uva-linklab/powerblade/eagle/powerblade/BOM_powerblade_v6.1.xlsx

Index | Quantity | DigiKey Part Number | Manufacturer Part Number | Description | Customer Reference | Type | Package
1 | 5 | 535-12373-6-ND | ABS06-107-32.768KHZ-T | CRYSTAL 32.7680KHZ 4PF SMD | X2 | smt | 805
2 | 5 | 887-2003-6-ND | 8Y-16.000MAAV-T | CRYSTAL 16.0000MHZ 8PF SMD | X1 | smt | TXC-8Y
3 | 5 | 296-25252-6-ND | OPA369AIDCKR | IC OPAMP GP 12KHZ RRO SC70-5 | U5 | smt | SC70-5
4 | 5 | 296-27695-6-ND | TPS62122DRVR | IC REG BUCK ADJ 75MA SYNC 6SON | U1 | fine pitch | WDFN-6
5 | 5 | 296-19547-6-ND | OPA333AIDCKR | IC OPAMP CHOPPER 350KHZ SC70-5 | U2 | smt | SC70-5
6 | 5 | P953KLDKR-ND | ERJ-2RKF9533X | RES SMD 953K OHM 1% 1/10W 0402 | R23,R24 | smt | R0402
7 | 5 | P887KLDKR-ND | ERJ-2RKF8873X | RES SMD 887K OHM 1% 1/10W 0402 | R22 | smt | R0402
8 | 5 | P665KLDKR-ND | ERJ-2RKF6653X | RES SMD 665K OHM 1% 1/10W 0402 | R20 | smt | R0402
9 | 5 | P560KLDKR-ND | ERJ-2RKF5603X | RES SMD 560K OHM 1% 1/10W 0402 | R18 | smt | R0402
10 | 5 | P665KLDKR-ND | ERJ-2RKF6653X | RES SMD 665K OHM 1% 1/10W 0402 | R21 | smt | R0402
11 | 5 | P665KLDKR-ND | ERJ-2RKF6653X | RES SMD 665K OHM 1% 1/10W 0402 | R19 | smt | R0402
12 | 5 | P330KLDKR-ND | ERJ-2RKF3303X | RES SMD 330K OHM 1% 1/10W 0402 | R16 | smt | R0402
13 | 5 | P330KLDKR-ND | ERJ-2RKF3303X | RES SMD 330K OHM 1% 1/10W 0402 | R17 | smt | R0402
14 | 5 | P180KLDKR-ND | ERJ-2RKF1803X | RES SMD 180K OHM 1% 1/10W 0402 | R14 | smt | R0402
15 | 5 | P47KJDKR-ND | ERJ-2GEJ473X | RES SMD 47K OHM 5% 1/10W 0402 | R12 | smt | R0402
16 | 5 | P220KJDKR-ND | ERJ-2GEJ224X | RES SMD 220K OHM 5% 1/10W 0402 | R15 | smt | R0402_SM
17 | 5 | P20.0KLDKR-ND | ERJ-2RKF2002X | RES SMD 20K OHM 1% 1/10W 0402 | R10 | smt | R0402
18 | 5 | P69.8KAADKR-ND | ERJ-14NF6982U | RES SMD 69.8K OHM 1% 1/2W 1210 | R13 | smt | R1210
19 | 5 | P30.0KLDKR-ND | ERJ-2RKF3002X | RES SMD 30K OHM 1% 1/10W 0402 | R11 | smt | R0402
20 | 5 | P16.0KLDKR-ND | ERJ-2RKF1602X | RES SMD 16K OHM 1% 1/10W 0402 | R9 | smt | R0402
21 | 5 | P3.00KLDKR-ND | ERJ-2RKF3001X | RES SMD 3K OHM 1% 1/10W 0402 | R6 | smt | R0402_SM
22 | 5 | P4.99KLDKR-ND | ERJ-2RKF4991X | RES SMD 4.99K OHM 1% 1/10W 0402 | R7 | smt | R0402
23 | 5 | P200LDKR-ND | ERJ-2RKF2000X | RES SMD 200 OHM 1% 1/10W 0402 | R4 | smt | R0402
24 | 5 | P1.00KLDKR-ND | ERJ-2RKF1001X | RES SMD 1K OHM 1% 1/10W 0402 | R5 | smt | R0402
25 | 5 | ED1649-ND | 0965-0-15-20-80-14-11-0 | CONTACT SPRING LOADED SMD GOLD | J1 | smt | Ultra Low Profile Spring Pin
26 | 5 | 587-1521-6-ND | HK100515NJ-T | FIXED IND 15NH 320MA 460 MOHM | L2 | smt | 0402_CAP
27 | 5 | P75.0LDKR-ND | ERJ-2RKF75R0X | RES SMD 75 OHM 1% 1/10W 0402 | R3 | smt | R0402
28 | 5 | 490-4025-6-ND | LQM18FN100M00D | FIXED IND 10UH 50MA 900 MOHM SMD | L4 | smt | C0603_TN
29 | 5 | 478-8650-6-ND | F981A336MSA | CAP TANT 33UF 20% 10V 0805 | C27 | smt | CPOL0805_SM
30 | 5 | 732-3452-6-ND | 744760410A | FIXED IND 10UH 80MA 5 OHM SMD | L3 | smt | L0805
31 | 5 | 490-4990-6-ND | LQH2MCN100M52L | FIXED IND 10UH 200MA 2.27 OHM | L1 | smt | L0805
32 | 5 | 445-13815-6-ND | C1005X5R0J155K050BB | CAP CER 1.5UF 6.3V X5R 0402 | C21 | smt | C0402
33 | 5 | 497-13637-6-ND | BAL-NRF01D3 | BALUN 2.4GHZ-2.54GHZ 5WFBGA | B1 | BGA | BAL-NRF01D3
34 | 5 | 296-22671-6-ND | OPA2369AIDCNT | IC OPAMP GP 12KHZ RRO SOT23-8 | U6 | smt | SOT-23-8
36 | 5 | 490-10987-6-ND | ZRB18AD71A106KE01L | CAP CER 10UF 10V X7T 0603 | C24 | smt | C0603_SM
37 | 5 | 720-1609-6-ND | VJ0402D220JLAAP | CAP CER 22PF 50V C0G/NP0 0402 | C6 | smt | C0402
38 | 5 | 399-8969-6-ND | C0402C473J4RACTU | CAP CER 0.047UF 16V X7R 0402 | C10 | smt | 0402_CAP
39 | 5 | 1727-1288-6-ND | NX3020NAKW,115 | MOSFET N-CH 30V 180MA SOT323 | Q2 | smt | SC-70-3
40 | 5 | 311-12.0KLRDKR-ND | RC0402FR-0712KL | RES SMD 12K OHM 1% 1/16W 0402 | R8 | smt | 0402_RES
41 | 5 | 490-14576-6-ND | GRM153R60J105ME95D | CAP CER 1UF 6.3V X5R 0402 | C20 | smt | 0402_CAP
42 | 5 | 399-17378-6-ND | C0402C222J3RAC7867 | CAP CER 2200PF 25V X7R 0402 | C9 | smt | 0402_CAP
43 | 5 | YAG3574DKR-ND | AC0603FR-071RL | RES SMD 1 OHM 1% 1/10W 0603 | R1 | smt | R0603_SM
44 | 5 | P1.0MJDKR-ND | ERJ-2GEJ105X | RES SMD 1M OHM 5% 1/10W 0402 | R25,R26,R27,R28 | smt | R0402
46 | 5 | 296-29232-6-ND | MSP430FR5738IRGER | IC MCU 16BIT 16KB FRAM 24VQFN | U3 | smt | VQFN-24
47 | 5 | BAS521Q-13DIDKR-ND | BAS521Q-13 | DIODE GEN PURP 300V 250MA SOD523 | D2 | smt | BAS521
48 | 5 | 490-10476-6-ND | GRM188R61A226ME15D | CAP CER 22UF 10V X5R 0603 | C25,C26 | smt | C0603_SM
49 | 5 | 490-5924-6-ND | GRM1555C1H120JA01D | CAP CER 12PF 50V C0G/NP0 0402 | C4,C5 | smt | 0402_CAP
50 | 5 | 490-6080-6-ND | GJM1555C1HR80BB01D | CAP CER 0.8PF 50V C0G/NP0 0402 | C1 | smt | 0402_CAP
51 | 5 | 478-7891-6-ND | 0402ZC104KAT2A | CAP CER 0.1UF 10V X7R 0402 | C11 | smt | C0402
52 | 5 | 541-4103-6-ND | CRCW04025R10FKEDC | RES SMD 5.1 OHM 1% 1/16W 0402 | R2 | smt | R0402
53 | 5 | CMOZ10VDKR-ND | CMOZ10V TR | DIODE ZENER 10V 300MW SOD523 | D1 | smt | BZT52
54 | 5 | 445-16101-6-ND | CGA2B3X7S1A474M050BB | CAP CER 0.47UF 10V X7S 0402 | C19 | smt | C0402
55 | 5 | 445-8023-6-ND | C1005X5R1A475M050BC | CAP CER 4.7UF 10V X5R 0402 | C22,C23 | smt | C0402
56 | 5 | 1490-1032-6-ND | NRF51822-QFAB-R7 | IC RF TXRX+MCU BLUETOOTH 48VFQFN | U4 | fine pitch | QFN-48-6MM
59 | 5 | 490-6348-6-ND | GRM155R71H102JA01D | CAP CER 1000PF 50V X7R 0402 | C7,C8 | smt | 0402_CAP
60 | 5 | 490-6327-2-ND | GRM155R71C104JA88D | CAP CER 0.1UF 16V X7R 0402 | C12, C13, C14, C15, C16, C17, C18 | smt | C0402
61 | 5 | 445-4890-6-ND | C1005C0G1H080C050BA | CAP CER 8PF 50V C0G 0402 | C02,C03 | smt | C0402
62 | 5 | 785-1085-6-ND | AO7401 | MOSFET P-CH 30V 1.4A SC70-3 | Q1 | smt | SC-70-3
64 | 5 |  | FR05-S1-N-0-110 | UREACH_XTEND | Y1 | smt | UREACH_XTEND
