uva-linklab/powerblade/eagle/powerblade/powerblade_5v0_bom.xlsx

Quantity | Part | Value | Device | Package | Description | Distributor | Dist Part # | Type | Alternate | Alternate2 | Mouser | Each 750 | Total 750 | Each 1000 | Total 1000
1 | B1 | BAL-NRF01D3 | BAL-NRF01D3 | BAL-NRF01D3 | 50 ohm nominal input / conjugate match balun to nRF51422-QFAA, |  | 497-13637-1-ND | BGA | 497-13637-1-ND |  |  | 0.42133 | 0.42133 | 0.3296 | 0.3296 | 0.3296
1 | C1 | 0.8pF | CAPACITOR | 0402_CAP | 0402 Capacitor |  | 490-6269-1-ND | smt | 490-6269-1-ND |  |  | 0.03904 | 0.03904 |  | 0 | 0.03904
2 | C2, C3 | 8pF | C-EUC0402 | C0402 | CAPACITOR, European symbol |  | 445-4890-1-ND | smt | 445-4890-1-ND |  |  | 0.01811 | 0.03622 |  | 0 | 0.03622
2 | C4, C5 | 12pF | CAPACITOR | 0402_CAP | 0402 Capacitor |  | 490-6197-1-ND | smt | 490-6196-1-ND | 490-8078-6-ND |  | 0.0553 | 0.1106 |  | 0 | 0.1106
1 | C6 | 22pF | C-EUC0402 | C0402 | CAPACITOR, European symbol |  | ~~445-1239-1-ND~~ | smt | ~~445-1239-1-ND~~ | 720-1609-6-ND |  | 0.37365 | 0.37365 | 0.32072 | 0.32072 | 0.32072 | y
2 | C7, C8 | 1nF | CAPACITOR | 0402_CAP | 0402 Capacitor |  | 490-1303-1-ND | smt | ~~490-1303-1-ND~~ | 490-4761-6-ND |  | 0.01606 | 0.03212 |  | 0 | 0.03212 | y
1 | C9 | 2.2nF | CAPACITOR | 0402_CAP | 0402 Capacitor |  | 490-5419-1-ND | smt | ~~490-5419-1-ND~~ | 399-1033-6-ND |  | 0.18593 | 0.18593 | 0.02955 | 0.02955 | 0.02955
1 | C10 | 47nF | CAPACITOR | 0402_CAP | 0402 Capacitor |  | 445-1264-1-ND | smt |  |  |  | 0.03 | 0.03 |  | 0 | 0.03
1 | C11, C12, C13, C14, C15, C16, C17, C18 | 0.1uF | C-EUC0402 | C0402 | CAPACITOR, European symbol |  | 490-10777-1-ND | smt | 399-7761-6-ND | 1276-1509-6-ND |  | 0.18593 | 0.18593 | 0.1092 | 0.1092 | 0.1092
1 | C19 | 470nF | C-EUC0402 | C0402 | CAPACITOR, European symbol |  | 445-4989-1-ND | smt | 445-13864-1-ND | 587-1455-6-ND |  | 0.05981 | 0.05981 |  | 0 | 0.05981
1 | C20 | 1uF | CAPACITOR | 0402_CAP | 0402 Capacitor |  | 1276-1513-1-ND | smt | 1276-1513-1-ND | 587-2477-6-ND |  | 0.05981 | 0.05981 |  | 0 | 0.05981 | y
1 | C21 | 1.5uF | C-EUC0402 | C0402 | CAPACITOR, European symbol |  | 445-13815-1-ND | smt |  |  |  | 0.11284 | 0.11284 | 0.09756 | 0.09756 | 0.09756
1 | C22, C23 | 4.7uF | C-EUC0402 | C0402 | CAPACITOR, European symbol |  | 445-8023-1-ND | smt | 445-13820-1-ND | 490-10984-6-ND |  | 0.13029 | 0.13029 | 0.10915 | 0.10915 | 0.10915
1 | C24 | 10uF | C-EUC0603_SM | C0603_SM | CAPACITOR, European symbol |  | 445-6853-1-ND | smt | 490-10987-6-ND |  |  | 0.15488 | 0.15488 | 0.12991 | 0.12991 | 0.12991 | y
2 | C25, C26 | 22uF | C-EUC0603_SM | C0603_SM | CAPACITOR, European symbol |  | 445-9077-1-ND | smt |  |  |  | 0.17573 | 0.35146 | 0.17456 | 0.34912 | 0.34912 | y
1 | C27 | 33uF | CPOL-US0805_SM | CPOL0805_SM | POLARIZED CAPACITOR, American symbol |  | 478-8650-1-ND | smt | 478-8650-1-ND |  |  | 0.45773 | 0.45773 | 0.20355 | 0.20355 | 0.20355
1 | D1 | ZENERBZT52 | ZENERBZT52 | BZT52 |  |  | BZT52C10T-7DICT-ND | smt |  |  |  | 0.08229 | 0.08229 |  | 0 | 0.08229 | y
1 | D2 | DIODE | DIODE | BAS521 |  |  | BAS521-7DICT-ND | smt |  |  |  | 0.12405 | 0.12405 | 0.08501 | 0.08501 | 0.08501 | y
4 | J1 | Ultra Low Profile Spring Pin | Ultra Low Profile Spring Pin | Ultra Low Profile Spring Pin |  |  | ED1649-ND | smt | ED1649-ND |  |  | 0.20355 | 0.8142 | 0.20355 | 0.8142 | 0.8142 | y
1 | L1 | 10uH | L-USL0805 | L0805 | INDUCTOR, American symbol |  | 490-4990-1-ND | smt |  |  |  | 0.23417 | 0.23417 | 0.17922 | 0.17922 | 0.17922 | y
1 | L2 | 15nH | INDUCTOR0402 | 0402_CAP |  |  | 587-1521-1-ND | smt |  |  |  | 0.02516 | 0.02516 |  | 0 | 0.02516 | y
1 | L3 |  | L-USL0805 | L0805 | INDUCTOR, American symbol |  | 732-3452-1-ND | smt |  |  | 710-744760410A | 0.34433 | 0.34433 | 0.313 | 0.313 | 0.313 | y
1 | L4 | 10uH | L-USL0603_TN | C0603_TN | INDUCTOR, American symbol |  | 490-4025-1-ND | smt | 535-12249-1-ND |  |  | 0.0838 | 0.0838 |  | 0 | 0.0838 | y
1 | Q1 | NTS4173 | NTS4173 | SC-70-3 |  |  | ~~NTS4173PT1GOSCT-ND~~ | smt | 785-1085-6-ND |  |  | 0.18644 | 0.18644 | 0.14323 | 0.14323 | 0.14323 | y
1 | Q2 | 2SK1829 | 2SK1829 | SC-70-3 |  |  | ~~2SK1829TE85LFCT-ND~~ | smt | 1727-1288-6-ND |  |  | 0.16332 | 0.16332 | 0.12545 | 0.12545 | 0.12545
1 | R1 | 1 1% | R-US_R0603_SM | R0603_SM | RESISTOR, American symbol |  | P1.0AJCT-ND | smt | P1.0AJCT-ND |  |  | 0.04537 | 0.04537 |  | 0 | 0.04537
1 | R2 | 4.99 1% | R-US_R0402 | R0402 | RESISTOR, American symbol |  | RMCF0402FT4R99CT-ND | smt | RMCF0402FT4R99CT-ND |  |  | 0.0068 | 0.0068 |  | 0 | 0.0068
1 | R3 | 75 1% | R-US_R0402 | R0402 | RESISTOR, American symbol |  | P75.0LCT-ND | smt | P75.0LCT-ND |  |  | 0.02693 | 0.02693 |  | 0 | 0.02693
1 | R4 | 200 | R-US_R0402 | R0402 | RESISTOR, American symbol |  | P200LCT-ND | smt | P200LCT-ND |  |  | 0.02693 | 0.02693 |  | 0 | 0.02693
1 | R5 | 1k 1% | R-US_R0402 | R0402 | RESISTOR, American symbol |  | P1.00KLCT-ND | smt | P1.00KLCT-ND |  |  | 0.02693 | 0.02693 |  | 0 | 0.02693
1 | R6 | 3k | R-US_R0402_SM | R0402_SM | RESISTOR, American symbol |  | P3.00KLCT-ND | smt | P3.00KLCT-ND |  |  | 0.02693 | 0.02693 |  | 0 | 0.02693
1 | R7 | 4.99k 1% | R-US_R0402 | R0402 | RESISTOR, American symbol |  | P4.99KLCT-ND | smt | P4.99KLCT-ND |  |  | 0.02693 | 0.02693 |  | 0 | 0.02693
1 | R8 | 12k | RESISTOR | 0402_RES | Resistor |  | RHM12.0KCDCT-ND | smt | RHM12.0KCDCT-ND | 311-12.0KLRDKR-ND |  | 0.01473 | 0.01473 |  | 0 | 0.01473
1 | R9 | 16k 1% | R-US_R0402 | R0402 | RESISTOR, American symbol |  | P16.0KLCT-ND | smt | P16.0KLCT-ND |  |  | 0.02693 | 0.02693 |  | 0 | 0.02693
1 | R10 | 20k | R-US_R0402 | R0402 | RESISTOR, American symbol |  | P20.0KLCT-ND | smt | P20.0KLCT-ND |  |  | 0.02693 | 0.02693 |  | 0 | 0.02693
1 | R11 | 30k 1% | R-US_R0402 | R0402 | RESISTOR, American symbol |  | P30.0KLCT-ND | smt | P30.0KLCT-ND |  |  | 0.02693 | 0.02693 |  | 0 | 0.02693
1 | R12 | 47k | R-US_R0402 | R0402 | RESISTOR, American symbol |  | P47KJCT-ND | smt | P47KJCT-ND |  |  | 0.02104 | 0.02104 |  | 0 | 0.02104
1 | R13 | 69.8k | R-US_R1210 | R1210 | RESISTOR, American symbol |  | P69.8KAACT-ND | smt | P69.8KAACT-ND |  |  | 0.11244 | 0.11244 |  | 0 | 0.11244
1 | R14 | 180k | R-US_R0402 | R0402 | RESISTOR, American symbol |  | P180KLCT-ND | smt | P180KLCT-ND |  |  | 0.02693 | 0.02693 |  | 0 | 0.02693
1 | R15 | 220k | R-US_R0402_SM | R0402_SM | RESISTOR, American symbol |  | P220KJCT-ND | smt | P220KJCT-ND |  |  | 0.02104 | 0.02104 |  | 0 | 0.02104
2 | R16, R17 | 330k | R-US_R0402 | R0402 | RESISTOR, American symbol |  | P330KLCT-ND | smt | P330KLCT-ND |  |  | 0.01258 | 0.02516 |  | 0 | 0.02516
1 | R18 | 560k | R-US_R0402 | R0402 | RESISTOR, American symbol |  | P560KLCT-ND | smt | P560KLCT-ND |  |  | 0.02693 | 0.02693 |  | 0 | 0.02693
3 | R19, R20, R21 | 665k | R-US_R0402 | R0402 | RESISTOR, American symbol |  | P665KLCT-ND | smt | P665KLCT-ND |  |  | 0.01102 | 0.03306 |  | 0 | 0.03306
1 | R22 | 887k 1% | R-US_R0402 | R0402 | RESISTOR, American symbol |  | P887KLCT-ND | smt | P887KLCT-ND |  |  | 0.02693 | 0.02693 |  | 0 | 0.02693
2 | R23, R24 | 953k 1% | R-US_R0402 | R0402 | RESISTOR, American symbol |  | P953KLCT-ND | smt | P953KLCT-ND |  |  | 0.01258 | 0.02516 |  | 0 | 0.02516
4 | R25, R26, R27, R28 | 1M 1% | R-US_R0402 | R0402 | RESISTOR, American symbol |  | P1.00MLCT-ND | smt | P1.00MLCT-ND |  |  | 0.00919 | 0.03676 | 0.00919 | 0.03676 | 0.03676
1 | U1 | TPS62122 | TPS62122 | WDFN-6 |  |  | 296-27695-1-ND | fine pitch | 296-27695-1-ND |  |  | 0.81953 | 0.81953 | 0.64663 | 0.64663 | 0.64663
1 | U2 | OPA333 | OPA333 | SC70-5 |  |  | 296-19547-1-ND | smt | 296-19547-1-ND |  |  | 1.6835 | 1.6835 | 1.3949 | 1.3949 | 1.3949
1 | U3 | MSP430FR5738 | MSP430FR5738 | VQFN-24 |  |  | 296-29232-1-ND | fine pitch | 296-29232-1-ND |  |  | 1.88078 | 1.88078 | 1.5862 | 1.5862 | 1.5862
1 | U4 | NRF51822QF | NRF51822QF | QFN-48-6MM | Multiprotocol Bluetooth® 4.0 low energy/2.4 GHz RF SoC |  | 1490-1032-1-ND | fine pitch | 1490-1032-1-ND |  |  | 2.39725 | 2.39725 | 1.918 | 1.918 | 1.918
1 | U5 | MAX9910 | MAX9910 | SC70-5 |  |  | 296-25252-1-ND | smt | 296-25252-1-ND |  |  | 1.3125 | 1.3125 | 1.0875 | 1.0875 | 1.0875
1 | U6 | OPA2369 | OPA2369 | SOT-23-8 |  |  | 296-22671-1-ND | smt | 296-22671-1-ND |  |  | 1.43692 | 1.43692 | 1.18985 | 1.18985 | 1.18985
1 | X1 | 16MHz | TXC-8Y | TXC-8Y | 2mmx1.6mm SMD Crystal |  | 887-2003-1-ND | smt | 887-2003-1-ND |  |  | 0.60333 | 0.60333 | 0.502 | 0.502 | 0.502
1 | X2 | 32.768kHz | CRYSTAL_0805 | 805 |  |  | 535-12373-1-ND | smt | 535-12373-1-ND |  |  | 0.54592 | 0.54592 | 0.45415 | 0.45415 | 0.45415
1 | Y1 | UREACH_XTEND | UREACH_XTEND | UREACH_XTEND |  |  | FR05-S1-N-0-110 | smt | FR05-S1-N-0-110 |  |  | 0.5 | 0.5 |  | 0 | 0.5
 |  |  |  |  |  | Board Summary for Quote
 |  |  |  |  |  | Total Unique Parts | 56
 |  |  |  |  |  | SMT placements per board | 69
 |  |  |  |  |  | Thru-hole per board | 0 |  |  |  |  |  | 16.61692 |  | 12.15446 | 13.81434 | 14.5
 |  |  |  |  |  | Fine pitch per board | 3 |  |  |  |  |  | 750 |  | 1000 | 1000 | 1001
 |  |  |  |  |  | BGA per board | 1 |  |  |  |  |  | 12462.69 |  | 12154.46 | 13814.34 | 14514.5
 |  |  |  |  |  |  |  |  |  | 25000 |  |  | 12537.31 |  | 12845.54 | 11185.66 | 10485.5
