uva-linklab/powerblade/eagle/powerblade/powerblade_v6.1_corr.brd

## EAGLE design eagle/powerblade/powerblade_v6.1_corr.brd (2019-08-09)

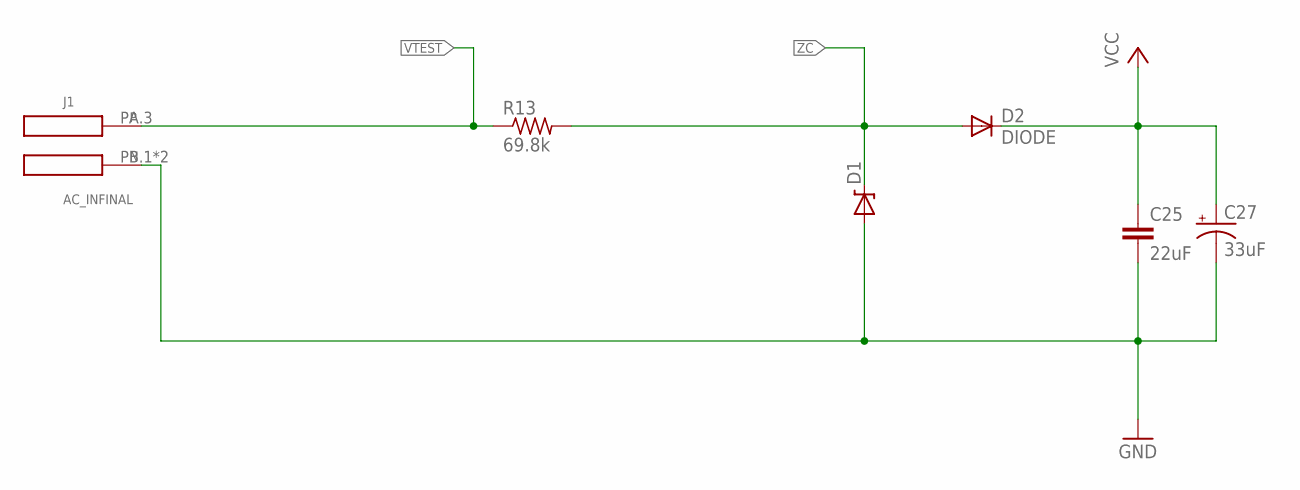
[picture p1: schematic powerblade_v6.1_corr.sch, sheet 1, AC-DC Power Supply]

Parts:
C25: 22uF; C0603_SM; DIGIKEY 445-9077-1-ND
C27: 33uF; CPOL0805_SM; DIGIKEY 478-8650-1-ND
D1: ZENERBZT52; BZT52; DIGIKEY BZT52C10T-7DICT-ND
D2: DIODE; BAS521
J1: AC_INFINAL; AC3_FINAL; DIGIKEY ED1649-ND
R13: 69.8k; R1210; DIGIKEY P69.8KAACT-ND

Connections:
GND: C25.2, C27.-, D1.A, J1.PB.1 (N), J1.PB.3 (N); also elsewhere on the board
VCC: C25.1, C27.+, D2.C; also elsewhere on the board
VTEST: J1.PA.3, R13.1; also elsewhere on the board
ZC: D1.C, D2.A, R13.2; also elsewhere on the board

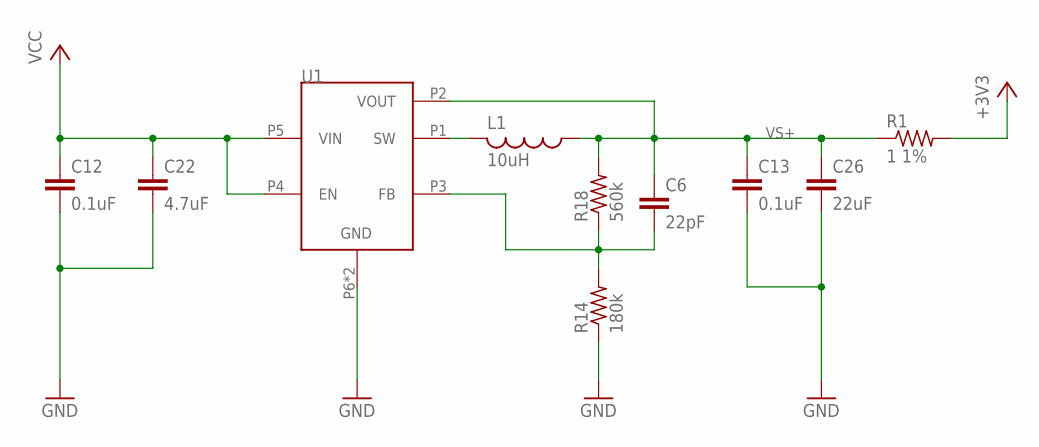
[picture p2: schematic powerblade_v6.1_corr.sch, sheet 2, Load Supply Regulation]

Parts:
C6: 22pF; C0402; DIGIKEY 445-1239-1-ND
C12: 0.1uF; C0402; DIGIKEY 445-4952-1-ND
C13: 0.1uF; C0402_SM; DIGIKEY 445-4952-1-ND
C22: 4.7uF; C0402; DIGIKEY 445-8023-1-ND
C26: 22uF; C0603_SM; DIGIKEY 445-9077-1-ND
L1: 10uH; L0805; DIGIKEY 490-4990-1-ND
R1: 1 1%; R0603_SM; DIGIKEY P1.0AJCT-ND
R14: 180k; R0402; DIGIKEY P180KLCT-ND
R18: 560k; R0402; DIGIKEY P560KLCT-ND
U1: TPS62122; WDFN-6

Connections:
+3V3: R1.2; also elsewhere on the board
GND: C12.2, C13.2, C22.2, C26.2, R14.1, U1.P6 (GND), U1.PAD (GND); also elsewhere on the board
unnamed: L1.2, U1.P1 (SW)
unnamed: C6.2, R14.2, R18.1, U1.P3 (FB)
VCC: C12.1, C22.1, U1.P4 (EN), U1.P5 (VIN); also elsewhere on the board
VS+: C6.1, C13.1, C26.1, L1.1, R1.1, R18.2, U1.P2 (VOUT)

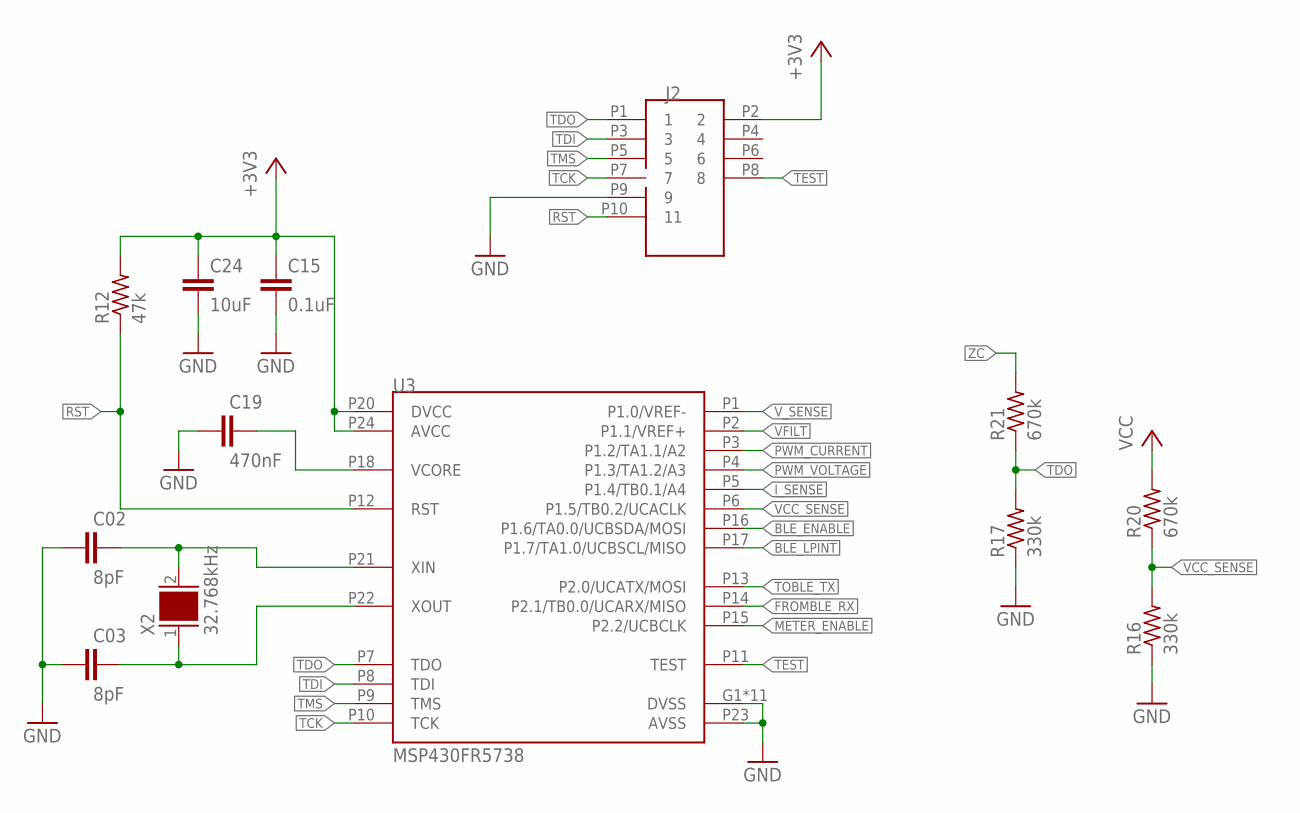
[picture p3: schematic powerblade_v6.1_corr.sch, sheet 3, MSP430FR5738]

Parts:
C02, C03: 8pF; C0402; DIGIKEY 445-4890-1-ND
C15: 0.1uF; C0402; DIGIKEY 445-4952-1-ND
C19: 470nF; C0402; DIGIKEY 445-4989-1-ND
C24: 10uF; C0603_SM; DIGIKEY 445-6853-1-ND
J2: JTAG_14PIN_IDC-ND; TC2050-IDC-NL-430-ND; DIGIKEY NP
R12: 47k; R0402; DIGIKEY P47KJCT-ND
R16, R17: 330k; R0402; DIGIKEY P330KLCT-ND
R20, R21: 670k; R0402; DIGIKEY P665KLCT-ND
U3: MSP430FR5738; VQFN-24
X2: 32.768kHz; 0805; DIGIKEY 535-12373-1-ND

Connections:
+3V3: C15.1, C24.1, J2.P2 (2), R12.2, U3.P20 (DVCC), U3.P24 (AVCC); also elsewhere on the board
BLE_ENABLE: U3.P16 (P1.6/TA0.0/UCBSDA/MOSI); also elsewhere on the board
BLE_LPINT: U3.P17 (P1.7/TA1.0/UCBSCL/MISO); also elsewhere on the board
FROMBLE_RX: U3.P14 (P2.1/TB0.0/UCARX/MISO); also elsewhere on the board
GND: C02.1, C03.1, C15.2, C19.1, C24.2, J2.P9 (9), R16.1, R17.1, U3.G1 (DVSS), U3.G2 (DVSS), U3.G3 (DVSS), U3.G4 (DVSS), U3.G5 (DVSS), U3.G6 (DVSS), U3.G7 (DVSS), U3.G8 (DVSS), U3.G9 (DVSS), U3.P19 (DVSS), U3.P23 (AVSS), U3.PAD (DVSS); also elsewhere on the board
I_SENSE: U3.P5 (P1.4/TB0.1/A4); also elsewhere on the board
METER_ENABLE: U3.P15 (P2.2/UCBCLK); also elsewhere on the board
unnamed: C03.2, U3.P22 (XOUT), X2.1
unnamed: C19.2, U3.P18 (VCORE)
unnamed: C02.2, U3.P21 (XIN), X2.2
PWM_CURRENT: U3.P3 (P1.2/TA1.1/A2)
PWM_VOLTAGE: U3.P4 (P1.3/TA1.2/A3)
RST: J2.P10 (11), R12.1, U3.P12 (RST)
TCK: J2.P7 (7), U3.P10 (TCK)
TDI: J2.P3 (3), U3.P8 (TDI)
TDO: J2.P1 (1), R17.2, R21.1, U3.P7 (TDO)
TEST: J2.P8 (8), U3.P11 (TEST)
TMS: J2.P5 (5), U3.P9 (TMS)
TOBLE_TX: U3.P13 (P2.0/UCATX/MOSI); also elsewhere on the board
VCC: R20.2; also elsewhere on the board
VCC_SENSE: R16.2, R20.1, U3.P6 (P1.5/TB0.2/UCACLK)
VFILT: U3.P2 (P1.1/VREF+); also elsewhere on the board
V_SENSE: U3.P1 (P1.0/VREF-); also elsewhere on the board
ZC: R21.2; also elsewhere on the board

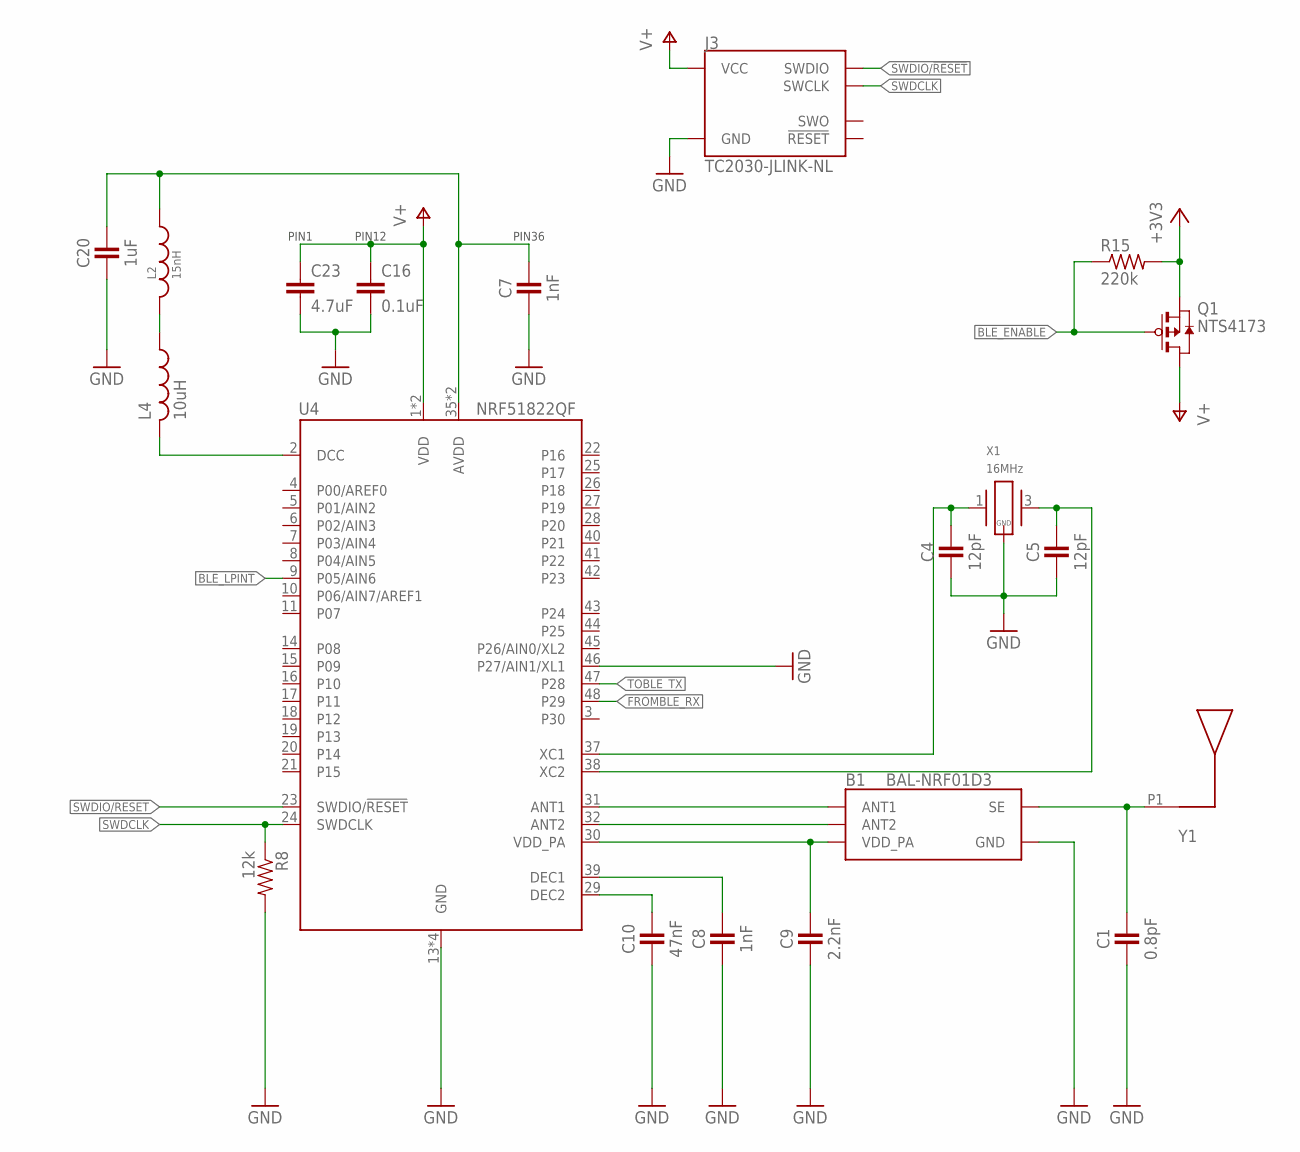
[picture p4: schematic powerblade_v6.1_corr.sch, sheet 4, nr51822]

Parts:
B1: BAL-NRF01D3
C1: 0.8pF; 0402_CAP; DIGIKEY 490-6269-1-ND
C4, C5: 12pF; 0402_CAP; DIGIKEY 490-6197-1-ND
C7, C8: 1nF; 0402_CAP; DIGIKEY 490-1303-1-ND
C9: 2.2nF; 0402_CAP; DIGIKEY 490-5419-1-ND
C10: 47nF; 0402_CAP; DIGIKEY 445-1264-1-ND
C16: 0.1uF; C0402; DIGIKEY 445-4952-1-ND
C20: 1uF; 0402_CAP; DIGIKEY 1276-1513-1-ND
C23: 4.7uF; C0402; DIGIKEY 445-5947-1-ND
J3: TC2030-JLINK-NL; TC2030-IDC-NL; DIGIKEY NP
L2: 15nH; 0402_CAP; DIGIKEY 587-1521-1-ND
L4: 10uH; C0603_TN; DIGIKEY 490-4025-1-ND
Q1: NTS4173; SC-70-3
R8: 12k; 0402_RES; DIGIKEY RHM12.0KCDCT-ND
R15: 220k; R0402_SM; DIGIKEY P220KJCT-ND
U4: NRF51822QF; QFN-48-6MM
X1: 16MHz; TXC-8Y; DIGIKEY 887-2003-1-ND
Y1: UREACH_XTEND

Connections:
+3V3: Q1.P2 (S), R15.2; also elsewhere on the board
AVDD: C7.1, C20.1, L2.1, U4.35 (AVDD), U4.36 (AVDD)
BLE_ENABLE: Q1.P1 (G), R15.1; also elsewhere on the board
BLE_LPINT: U4.9 (P05/AIN6); also elsewhere on the board
DCC: L4.2, U4.2 (DCC)
FROMBLE_RX: U4.48 (P29); also elsewhere on the board
GND: B1.GND, C1.2, C4.2, C5.2, C7.2, C8.2, C9.2, C10.2, C16.2, C20.2, C23.2, J3.5 (GND), R8.2, U4.13 (GND), U4.33 (GND), U4.34 (GND), U4.46 (P27/AIN1/XL1), U4.GND, X1.2 (GND), X1.4 (GND); also elsewhere on the board
unnamed: B1.SE, C1.1, Y1.P1
unnamed: B1.ANT1, U4.31 (ANT1)
unnamed: B1.ANT2, U4.32 (ANT2)
unnamed: L2.2, L4.1
unnamed: C4.1, U4.37 (XC1), X1.1
unnamed: C5.1, U4.38 (XC2), X1.3 (2)
unnamed: C8.1, U4.39 (DEC1)
unnamed: C10.1, U4.29 (DEC2)
SWDCLK: J3.4 (SWCLK), R8.1, U4.24 (SWDCLK)
SWDIO/!RESET: J3.2 (SWDIO), U4.23 (SWDIO/!RESET)
TOBLE_TX: U4.47 (P28); also elsewhere on the board
V+: C16.1, C23.1, J3.1 (VCC), Q1.P3 (D), U4.1 (VDD), U4.12 (VDD)
VDD_PA: B1.VCC (VDD_PA), C9.1, U4.30 (VDD_PA)

Notes on the sheet:
PIN12
PIN1
PIN36

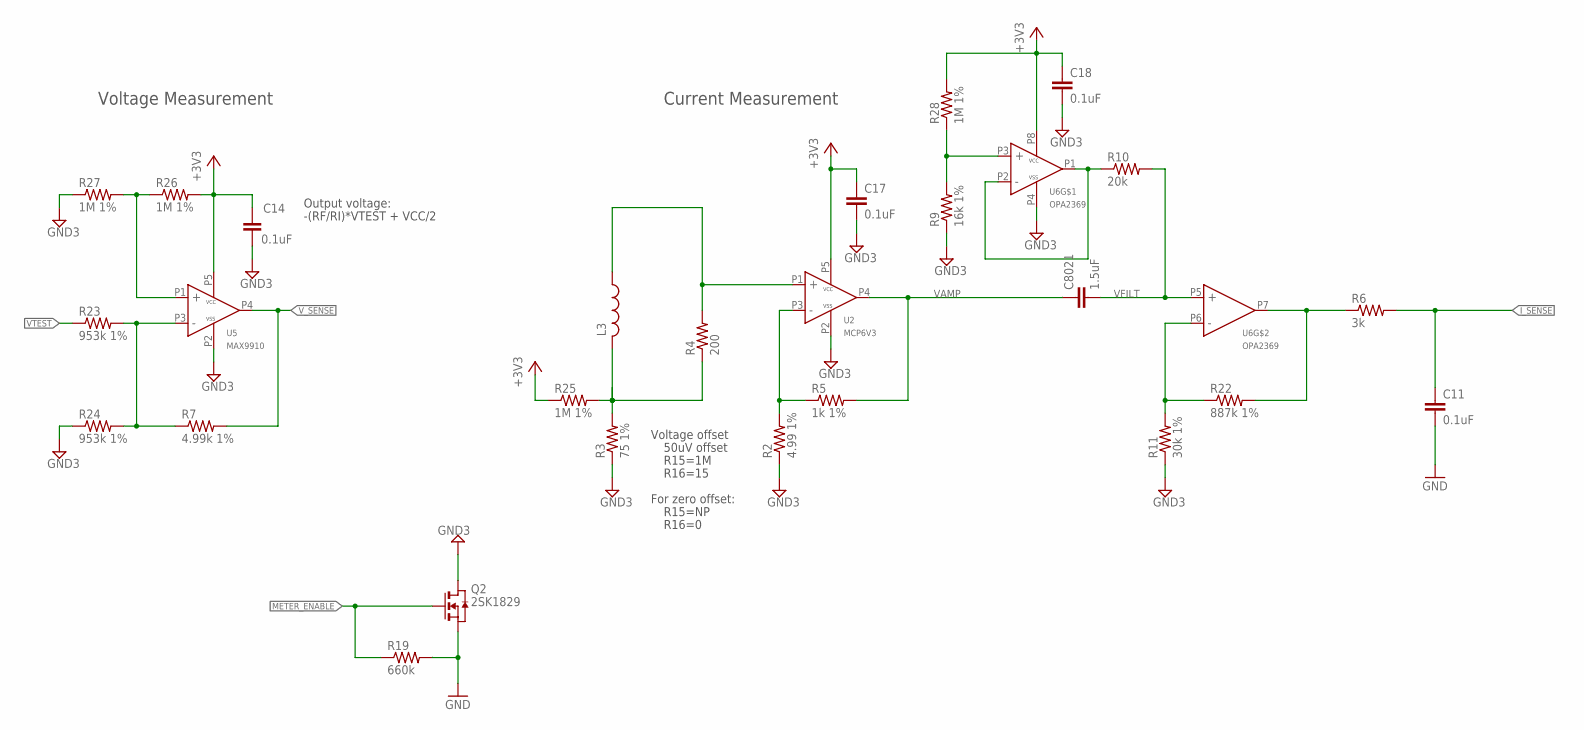
[picture p5: schematic powerblade_v6.1_corr.sch, sheet 5, Power Sensing!]

Parts:
C11: 0.1uF; C0402; DIGIKEY 490-10777-1-ND
C14: 0.1uF; 0402_CAP; DIGIKEY 445-4952-1-ND
C17, C18: 0.1uF; C0402; DIGIKEY 445-4952-1-ND
C8021: 1.5uF; C0402; DIGIKEY 445-13815-1-ND
L3: L-USL0805; L0805; DIGIKEY 732-3452-1-ND
Q2: 2SK1829; SC-70-3
R2: 4.99 1%; R0402; DIGIKEY RMCF0402FT4R99CT-ND
R3: 75 1%; R0402; DIGIKEY P75.0LCT-ND
R4: 200; R0402; DIGIKEY P200LCT-ND
R5: 1k 1%; R0402; DIGIKEY P1.00KLCT-ND
R6: 3k; R0402_SM; DIGIKEY P3.00KLCT-ND
R7: 4.99k 1%; R0402; DIGIKEY P4.99KLCT-ND
R9: 16k 1%; R0402; DIGIKEY P16.0KLCT-ND
R10: 20k; R0402; DIGIKEY P20.0KLCT-ND
R11: 30k 1%; R0402; DIGIKEY P30.0KLCT-ND
R19: 660k; R0402; DIGIKEY P665KLCT-ND
R22: 887k 1%; R0402; DIGIKEY P887KLCT-ND
R23, R24: 953k 1%; R0402; DIGIKEY P953KLCT-ND
R25, R26, R28: 1M 1%; R0402; DIGIKEY P1.00MLCT-ND
R27: 1M 1%; R0402_SM; DIGIKEY P1.00MLCT-ND
U2: MCP6V3; SC70-5; DIGIKEY 296-19547-1-ND
U5: MAX9910; SC70-5; DIGIKEY 296-25252-1-ND
U6: OPA2369; SOT-23-8

Connections:
+3V3: C14.1, C17.1, C18.1, R25.1, R26.2, R28.2, U2.P5 (VCC), U5.P5 (VCC), U6.P8 (VCC); also elsewhere on the board
GND: C11.2, Q2.P2 (S), R19.2; also elsewhere on the board
GND3: C14.2, C17.2, C18.2, Q2.P3 (D), R2.1, R3.1, R9.1, R11.1, R24.1, R27.1, U2.P2 (VSS), U5.P2 (VSS), U6.P4 (VSS)
I_SENSE: C11.1, R6.2; also elsewhere on the board
METER_ENABLE: Q2.P1 (G), R19.1; also elsewhere on the board
unnamed: R6.1, R22.2, U6.P7 (OUT)
unnamed: L3.2, R3.2, R4.1, R25.2
unnamed: L3.1, R4.2, U2.P1 (IN+)
unnamed: R26.1, R27.2, U5.P1 (IN+)
unnamed: R7.1, R23.2, R24.2, U5.P3 (IN-)
unnamed: R2.2, R5.1, U2.P3 (IN-)
unnamed: R11.2, R22.1, U6.P6 (IN-)
unnamed: R10.1, U6.P1 (OUT), U6.P2 (IN-)
unnamed: R9.2, R28.1, U6.P3 (IN+)
VAMP: C8021.1, R5.2, U2.P4 (OUT)
VFILT: C8021.2, R10.2, U6.P5 (IN+); also elsewhere on the board
VTEST: R23.1; also elsewhere on the board
V_SENSE: R7.2, U5.P4 (OUT); also elsewhere on the board

Notes on the sheet:
Voltage offset
50uV offset
For zero offset:
R15=NP
R16=0
Current Measurement
Voltage Measurement
Output voltage:
-(RF/RI)*VTEST + VCC/2
R15=1M
R16=15

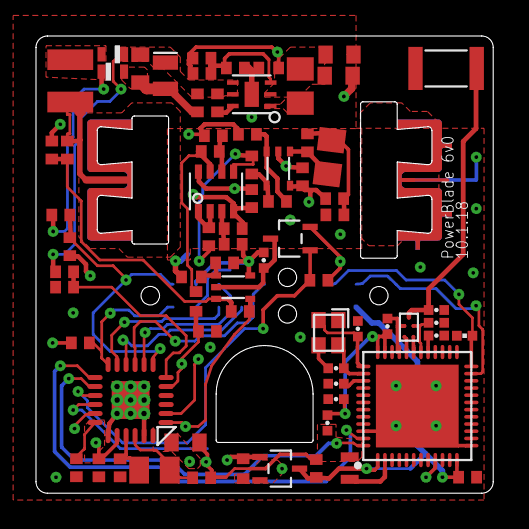
[picture p6: board powerblade_v6.1_corr.brd from above]

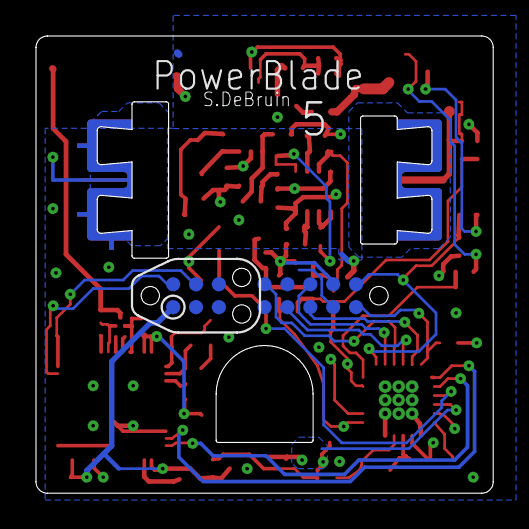
[picture p7: board powerblade_v6.1_corr.brd from below]

Board: 4 copper layers, 25.4 x 25.4 mm, 76 parts (2 on the bottom side), 51 nets.
